LaskaKit/microESPswitch/img/laskakit-microespswitch-3.jpg

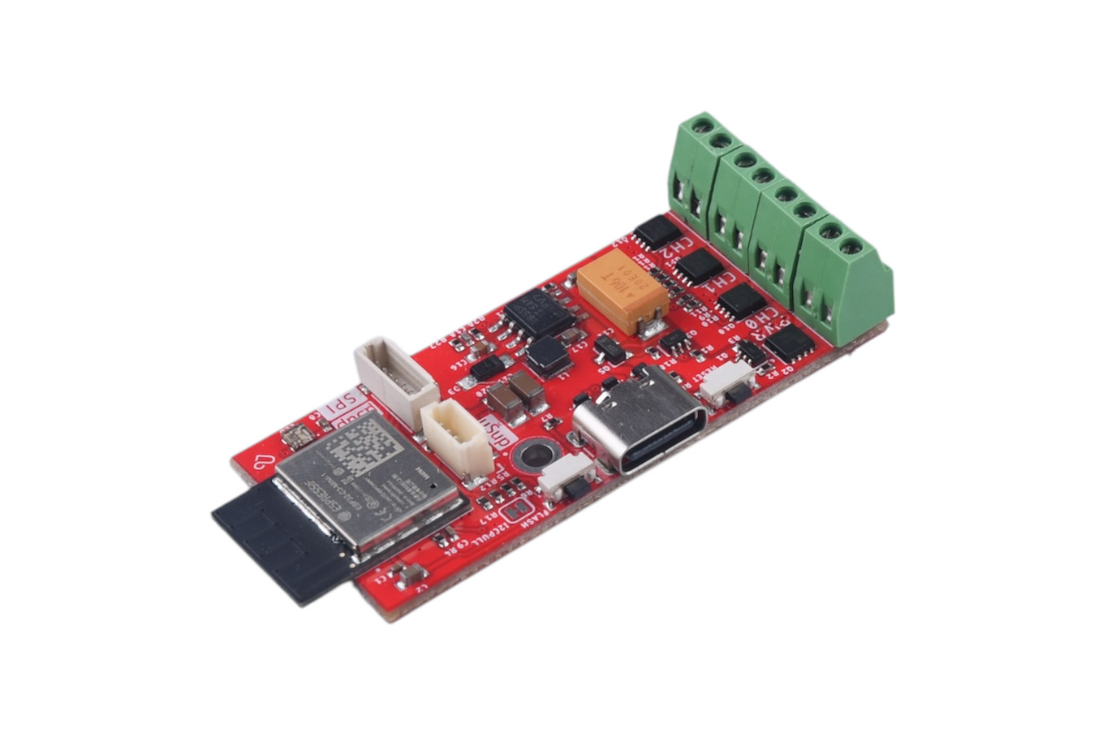
img/laskakit-microespswitch-3.jpg
