LaskaKit/microESPswitch/img/laskakit-microespswitch-4.jpg

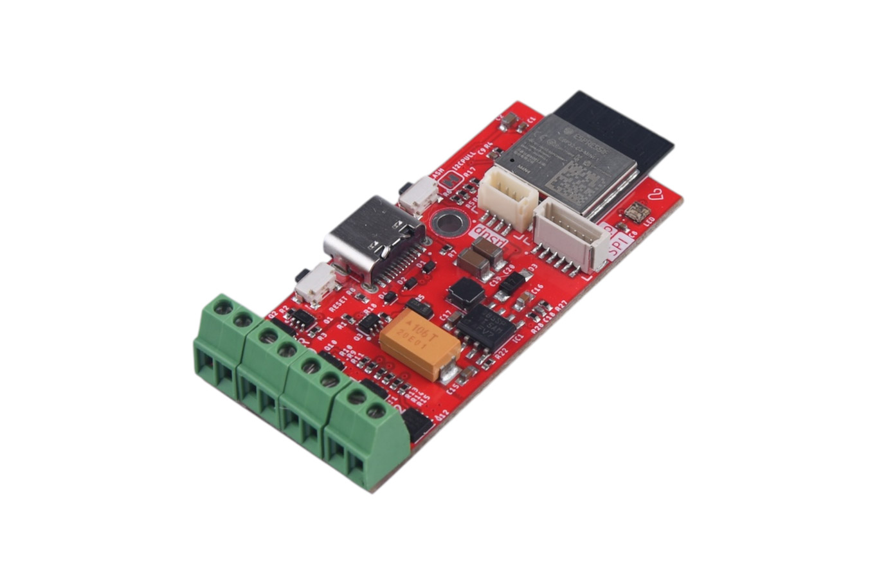
img/laskakit-microespswitch-4.jpg
