LaskaKit/microESPswitch/Version.md

### Version 1.3
- Resistors moved from bottom to top layer
- I2C SDA and SCL pins are swapped
#### Version 1.2
- Ceramic capacitor changed to tantalum because of noise they making
#### Version 1.1
- LED IO chnged from 21 to 9
- FSPI_CS IO changed to 3
### Version 1.0
- Initial | Počáteční
