LaskaKit/microESPswitch/img/laskakit-microespswitch-1.jpg

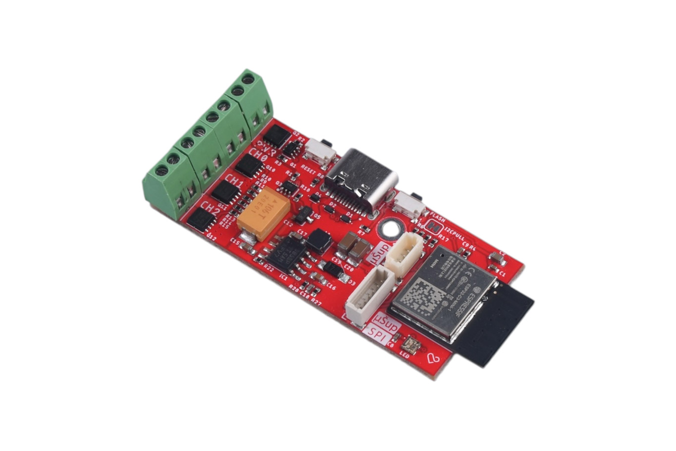
img/laskakit-microespswitch-1.jpg
