LaskaKit/microESPswitch/img/laskakit-microespswitch-2.jpg

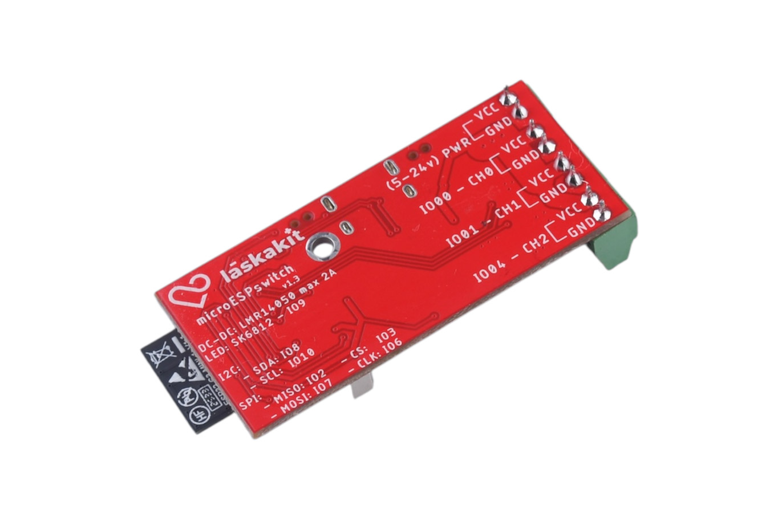
img/laskakit-microespswitch-2.jpg
