LaskaKit/microESPswitch/HW/microESPswitch_v1-1.pdf

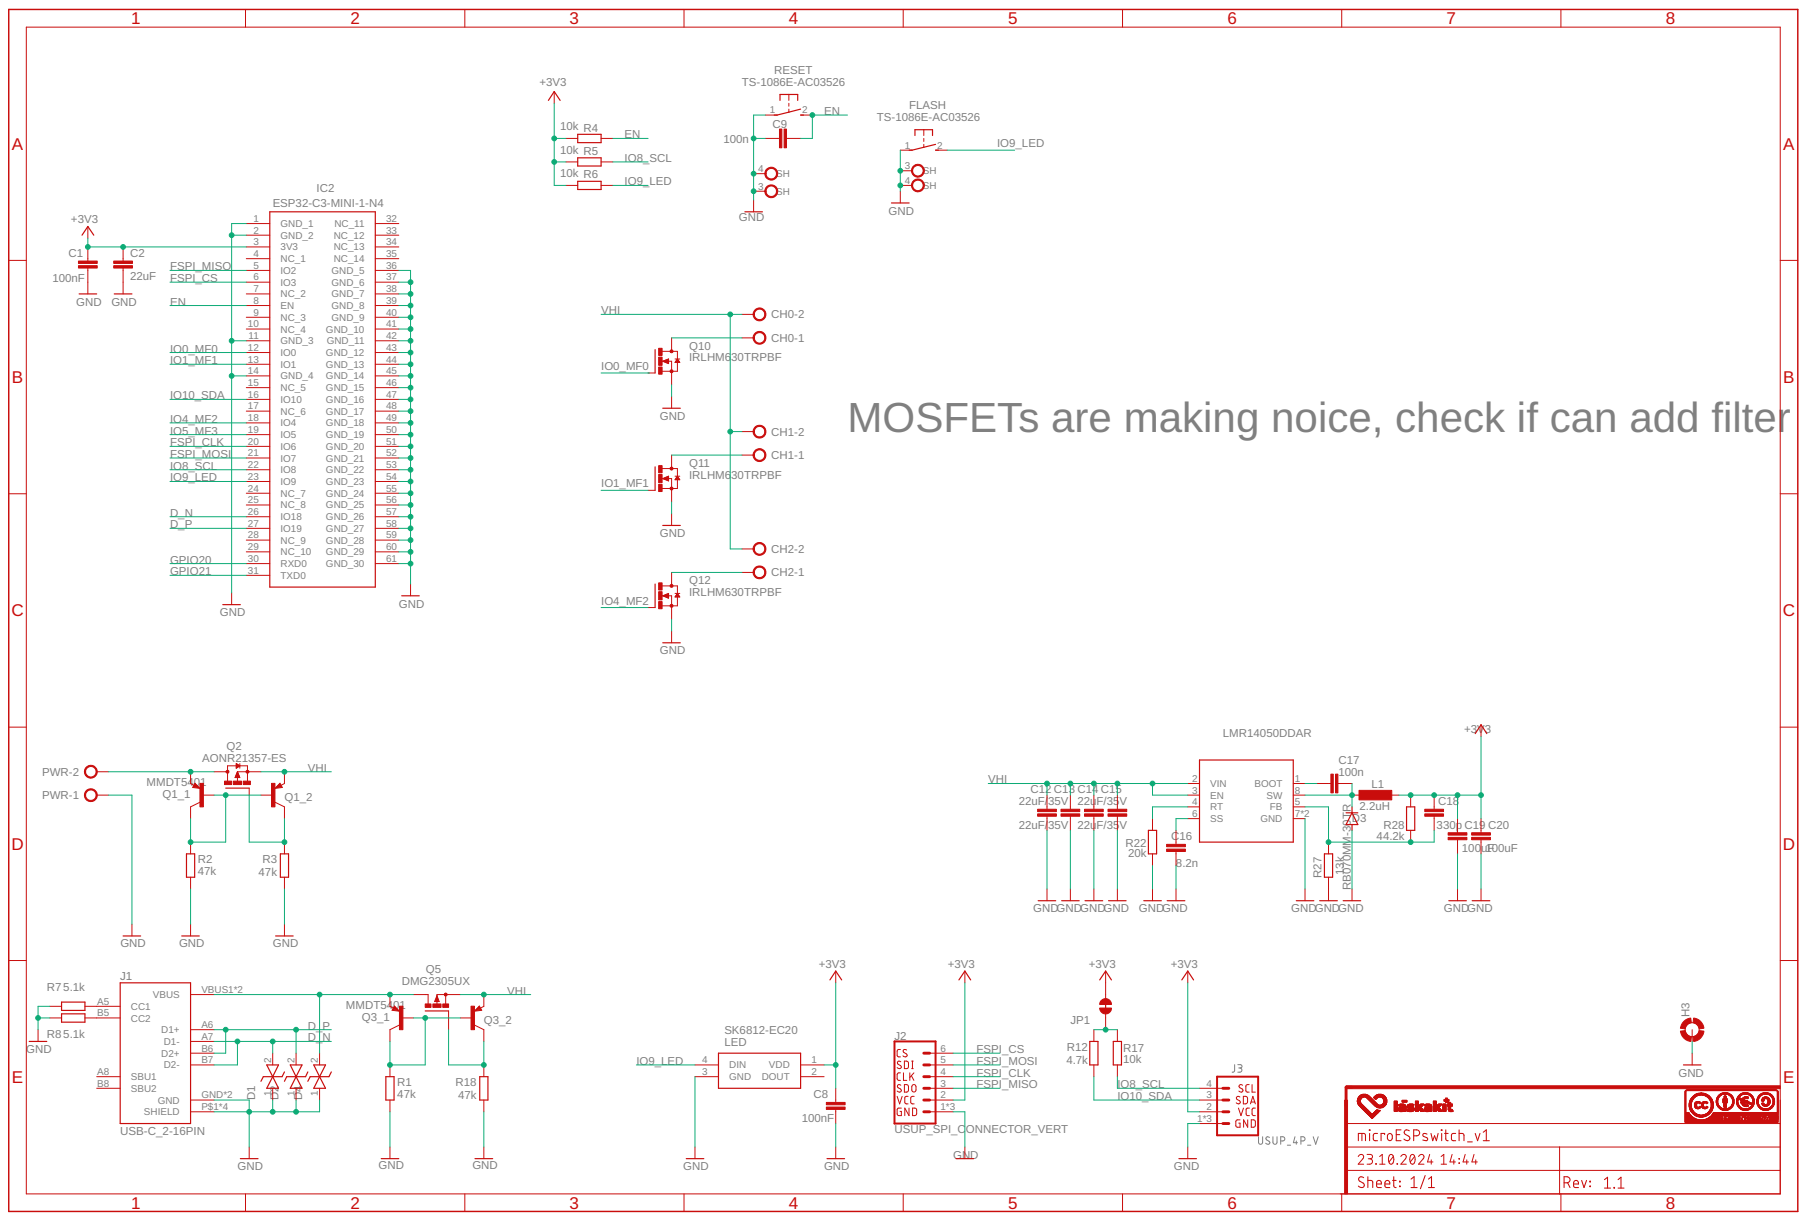
[picture p5: page 1]

MOSFETs are making noice, check if can add filter
