LaskaKit/microESPswitch/HW/microESPswitch_v1-3.pdf

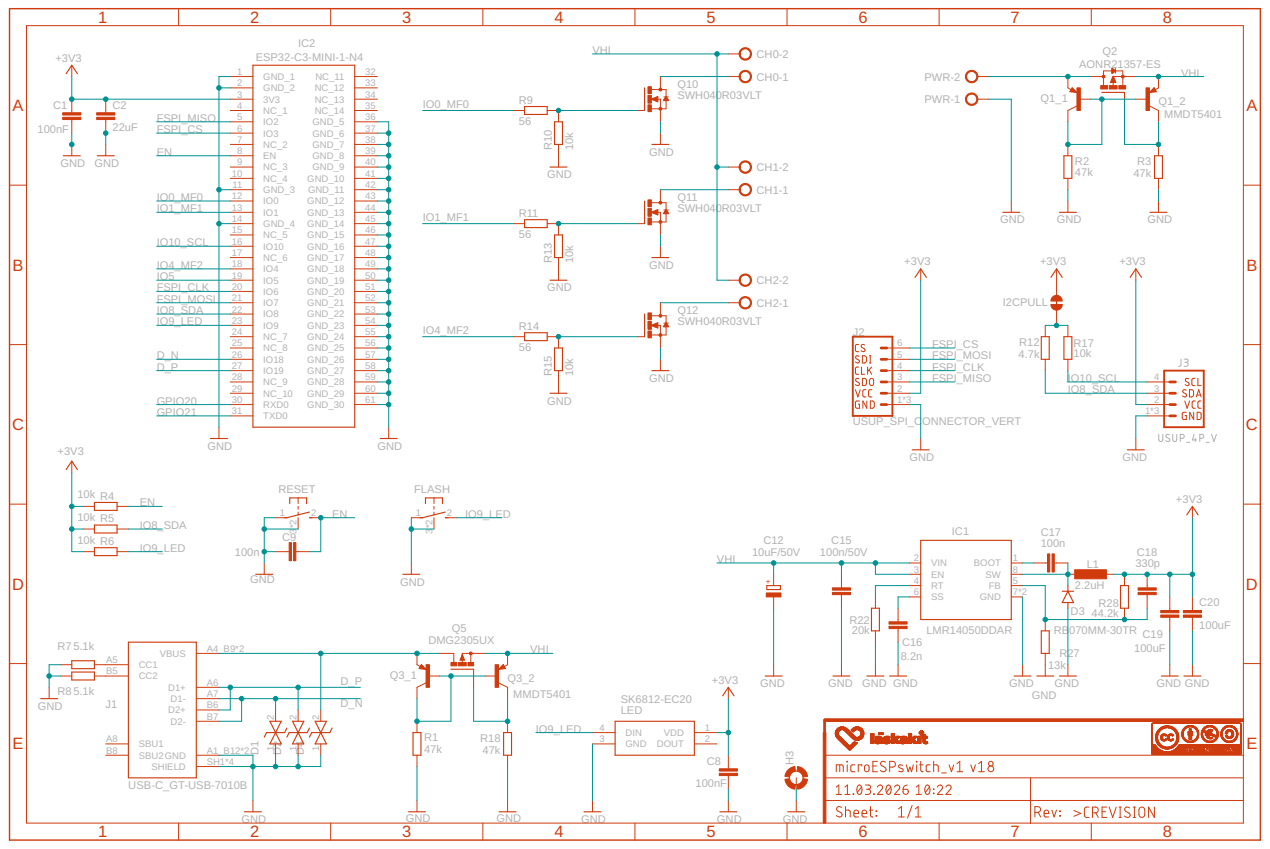
[picture p6: page 1]
