LaskaKit/microESPswitch/HW/microESPswitch_v1.pdf

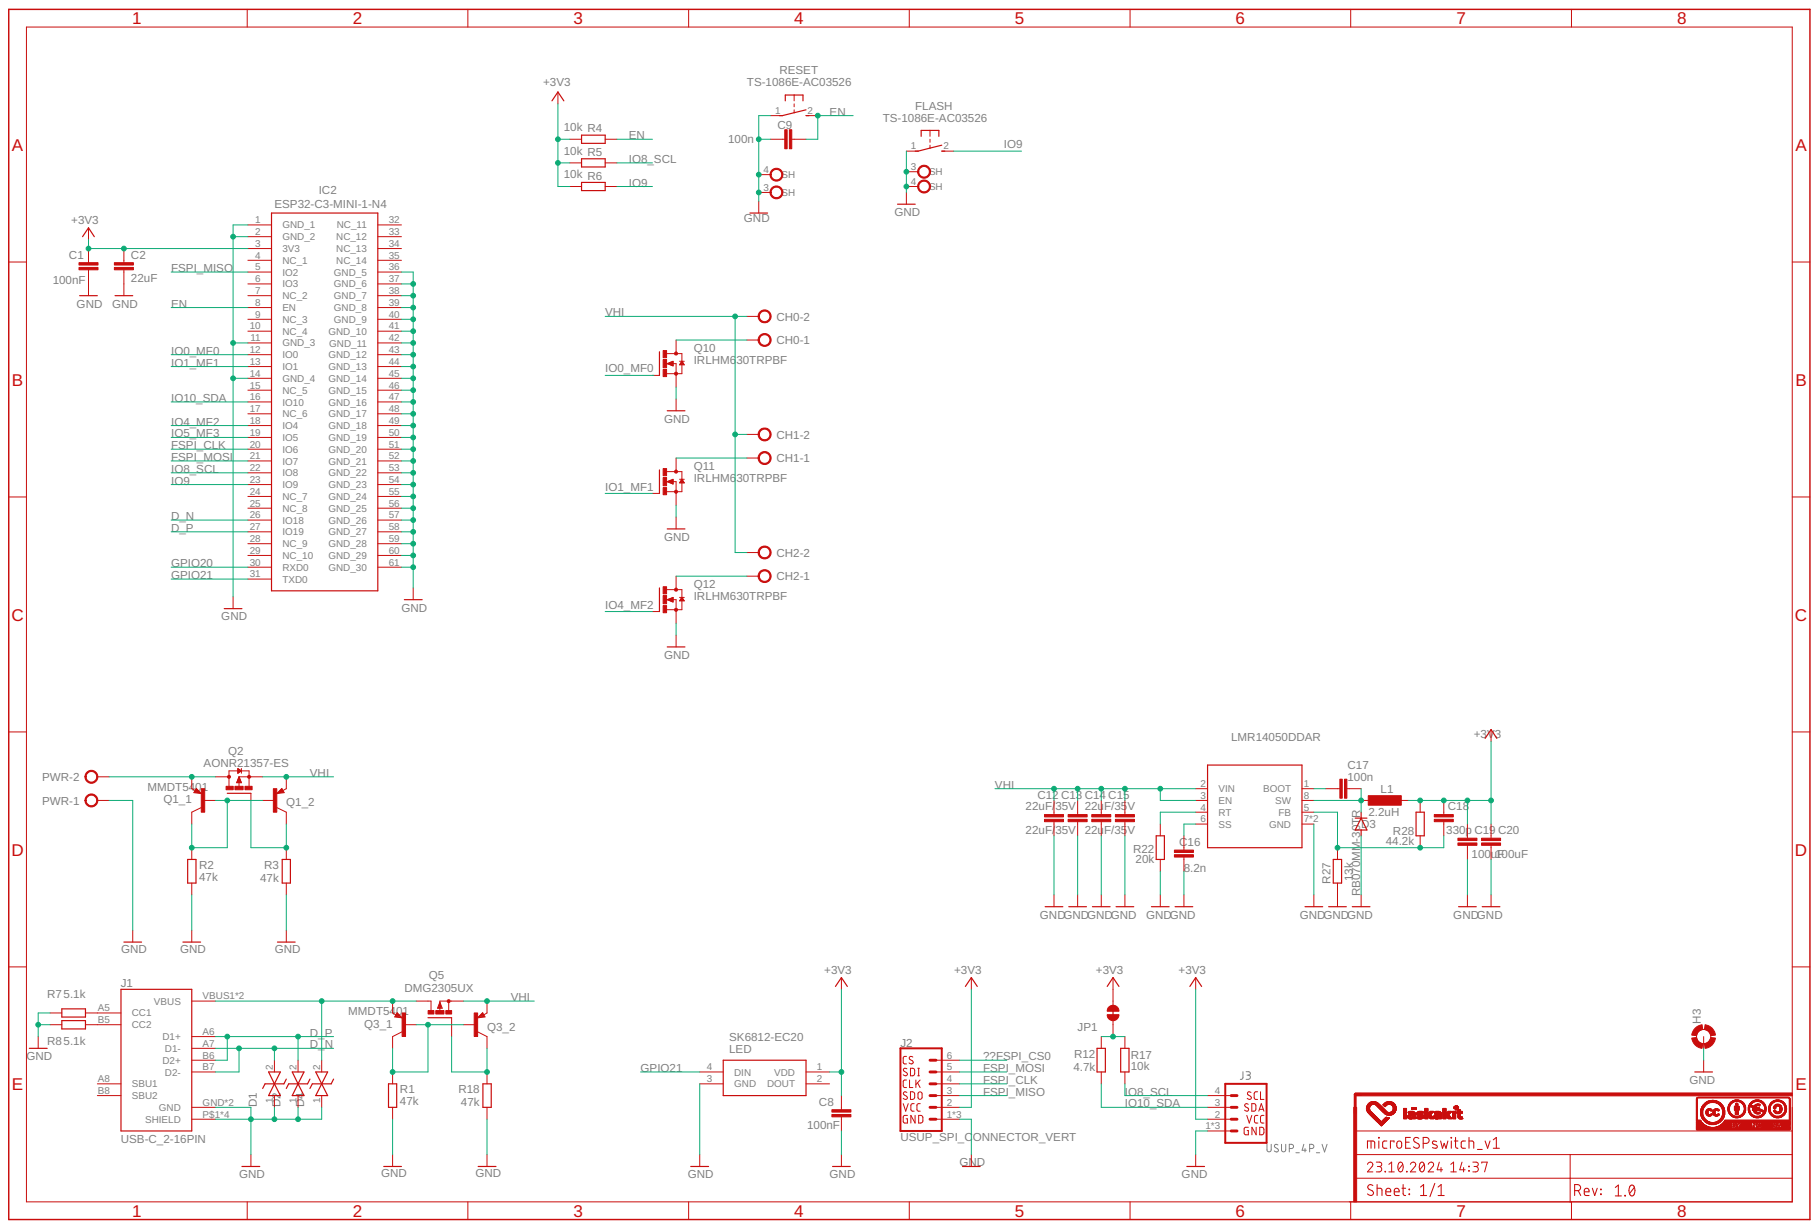
[picture p7: page 1]
