LaskaKit/microESPswitch/(commit log)

2025-03-09 new ver
    [DRILEGEND.CFG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]
2026-02-11 new data
    [microESPswitch_v1-1_bom.csv, microESPswitch_v1.2 v22_bom.csv, microESPswitch_v1.2 v6_bom.csv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]
